maurosollar/STM32H562RGT6-InvPend/README.md

# Pêndulo invertido

Projeto experimental de um sistema de pêndulo invertido utilizando STM32H562RGT6, driver DM556 e motor de passo para estudo de controle PID e LQR. O objetivo é desenvolver uma plataforma open-source para estudos de sistemas instáveis.

## Estratégia de Controle

O projeto utiliza duas etapas principais de controle:

### Swing-Up

Responsável por elevar o pêndulo da posição inferior até próximo da vertical.

O algoritmo aplica acelerações controladas no carrinho para aumentar
gradualmente a energia do pêndulo até atingir a região de captura.

### Estabilização

Após atingir a região próxima da vertical de captura, o sistema troca automaticamente
para o controlador de estabilização.

Controladores previstos:

- PID
- LQR

A transição entre Swing-Up e estabilização ocorre automaticamente
baseada no ângulo do pêndulo.

## Documentação

- [Lista de materiais](./boom.txt)
- [Diagrama da placa STM32](./Docs/WeAct-STM32H5_64PIN-CoreBoard_V11%20SchDoc.pdf)

## Fotos

### STM32 / Driver  / Encoder de 2500 pulsos por revolução / Motor de passo

<p float="left">
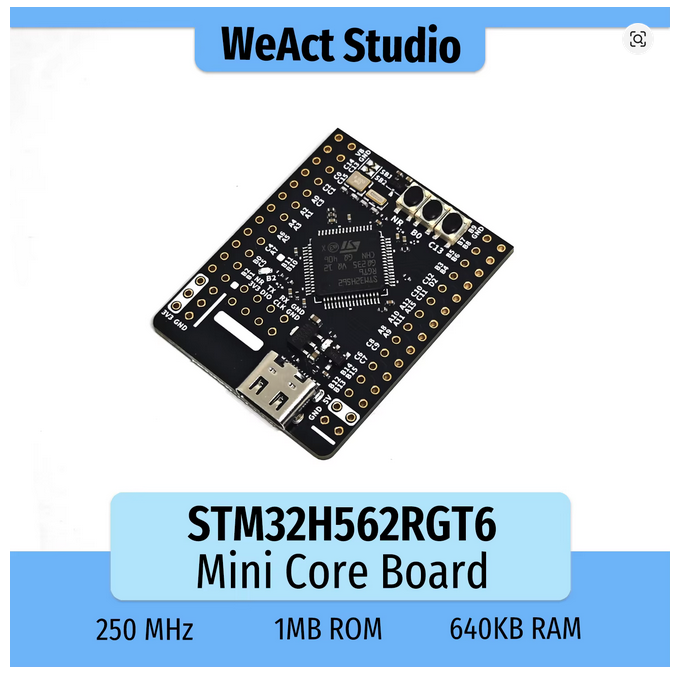
[picture p1: Docs/STM32H562RGT6.png]
    
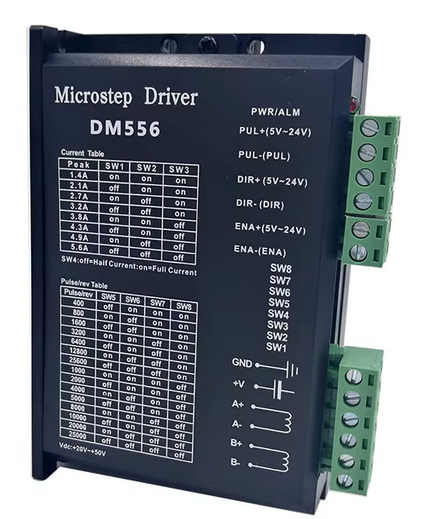
[picture p2: Docs/DM556.png]
    
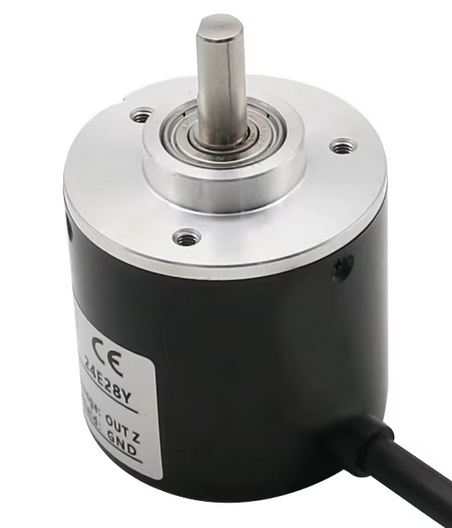
[picture p3: Docs/Encoder_Incremental.png]
    
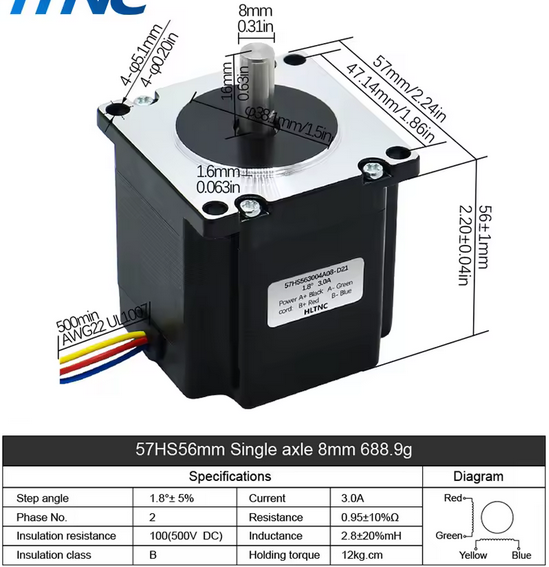
[picture p4: Docs/Nema23_Step_Motor.png]
        
</p>

### Início da separação dos materiais

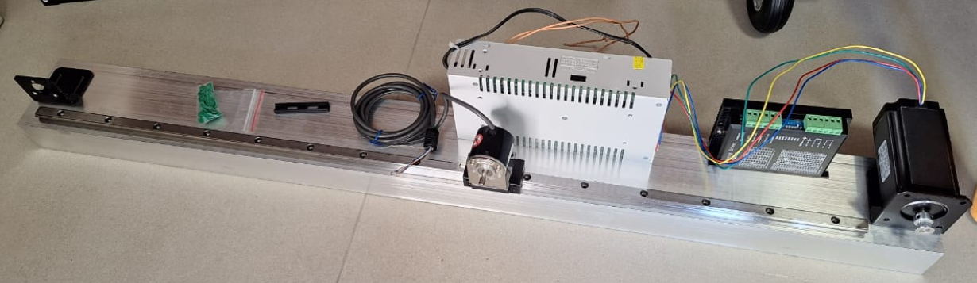
[picture p5: Docs/montagem01.png]


### Montagem final

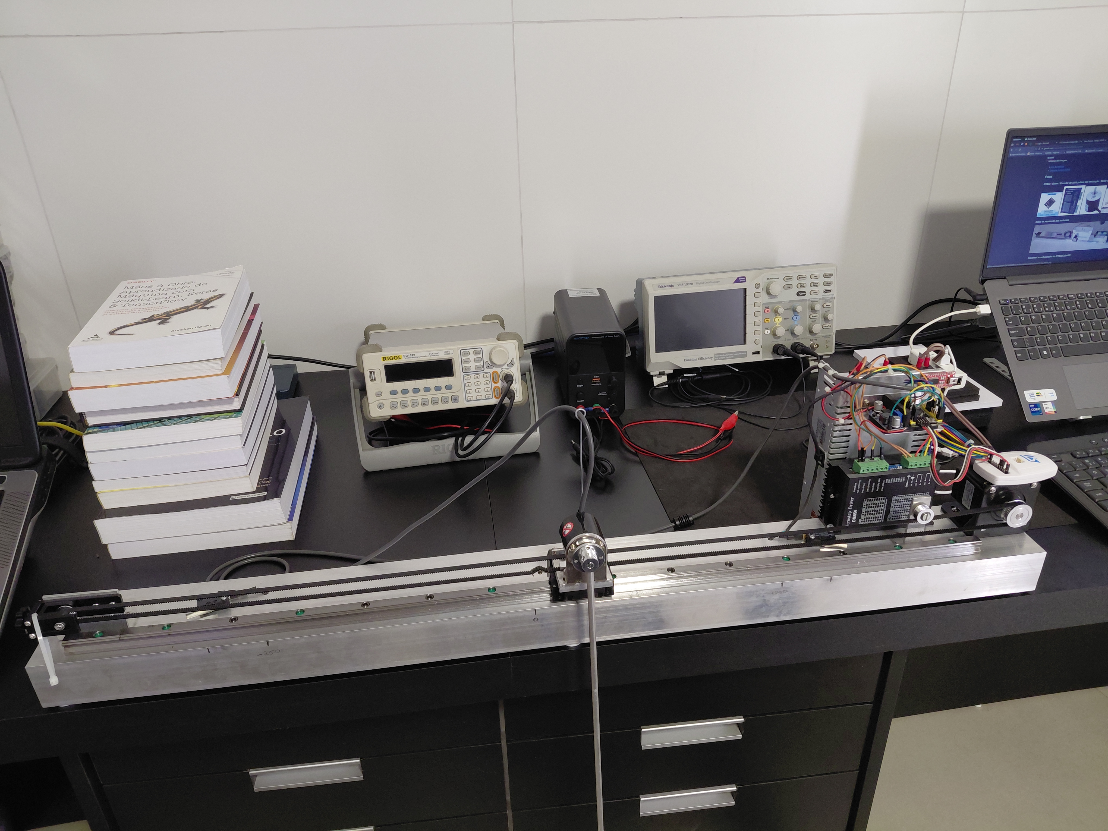
[picture p6: Docs/montagem_final.jpg]


### Iniciando a configuração do STM32CubeMX

```
STMCubeMX Version 6.17.0
Start My project from MCU
  Access to mcu selector
  
  For better performance it is recommended to enable the instruction cache (ICACHE)
  and the MPU to access OTP & RO areas.
  Do you want to apply now such default configuration? (YES)
  
  Do you want to create a new project:
  (*) Without TrustZone activated?
  
  Aba Project Manager
    Project Name: STM32H562RGT6-InvPend
    Toolchain / IDE: STMCubeIDE
  
  Linker Settings
    Minimum Heap Size 0x200
    Minimum Stack Size 0x400
    
  Aba Pinout & Configuration
    System Core
      RCC
        HSE: Crystal/Ceramic Resonator
        LSE: Crystal/Ceramic Resonator

    Trace and Debug
      DEBUG Mode and Copnfiguration
        Debug: Serial Wire        
        
  Aba Clock Configuration
    Input frequency LSE: 32.768KHz
    Input frequency HSE: 8MHz
    HCLK(MHz): 250
    Importante observar se o clock da USB esta a 48MHz, já que vamos utilizar
    a USB como Virtual Port Communications. Já Certo que estamos utilizando
    HSE e LSE ativado para utilizar Cristal externo.

=== Parte do encoder ===

Pinout & Configuration / Timers
  TIM2
    Combined Channels: Encoder Mode
      Configuration / User Constants
        Add
        Constant Name: ENCODER_RESOLUTION
        Constant Value: 9999 (10000 - 1 contagens por volta)
      Configuration / Parameter Settings    
        Counter Settings
          Counter Period (AutoReloadRegister 32bits): ENCODER_RESOLUTION
          Internal Clock Division(CKD): No Division
          auto-reload preload: Enable
        Encoder
          Encoder Mode: Encoder Mode TI1 and TI2
          __ Parameters for Channel 1 ___
          Polarity: Falling Edge
          Input filter: 10
          __ Parameters for Channel 2 ___
          Polarity: Falling Edge
          Input filter: 10   
      Configuration / NVIC Settings
        TIM2 global interrupt ( )  Obs.: Interupção de over ou underflow, não ativado.
      Configuration / GPIO Settings
        Fazer para PA0 e PA1
        GPIO pull-up/Pull-down: Pull-up

=== Configurar GPIO's de saída para PUL-, DIR- e ENA- ===
Pinout & Configuration
  Obs.: PUL- = PA2 associado com TIM5_CH3 PWM Generation
  PA9 e PA10 como GPIO_Output
  PA9 com label: DIR
  PA10 com label: ENA
  GPIO mode: Output Open Drain (Configurado como coletor aberto pelo fato do PUL+, DIR+ e ENA+
                                esta conectado no 5VDC)
  PA4 com label: Encoder_Rev como GPIO_Input Pull-up (Não utilizado)
  PA6 com label: Chave_Esq como GPIO_Input Pull-up
  PA7 com label: Chave_Dir como GPIO_Input Pull-up
  PB13 com label: Time_Int como GPIO_Output (Utilizado para debug de tempo de interrupção)
  PC11 com label: Time_Exec como GPIO_Output (Utilizado para debug de tempo de execuçao de código)

=== Configuração da UART ===
Pinout & Configuration
  Connectivity
    UART4
    UART4 Mode and Configuration
      Mode
        Mode: Asynchronous
      Configuration
        Parameters
          Baud Rate: 460800
          Word Length: 8 Bits
          Parity: None
          Stop Bits: 1
        NVIC Settings
          UART4 global interrupt [*]
        DMA Settings
          Clique em "Go to GPDMA1"

Logo clicando em "Go to GPDMA1" redireciona para o System Core
System Core
   GPDMA1
     Channel 0 -2 Words Internal FIFO : Standarda Request mode
       Request Configuration
         Request UART4_TX
       Channel configuration
         Direction Memory to Peripheral
       Source Data Setting
         Source Address increment After Transfer: Enabled
         Data Width: Byte
       Destination Data Setting
         Destination Address increment After Transfer: Disable
         Data Width: Byte
Obs.: Foram ativados PC10=UART4_TX e PA11=UART4_RX

=== Configurando Timer para interrupção por software de 1 ms ===
Pinout & Configuration
  Timers
    TIM3
      Mode
        Clock Source: Internal Clock (Na árvore de clock APB1 Timer clock = 250MHz)
      Configuration
        Parameters Settings
          Prescaler (PSC - 16 bits value): 250-1 (Então o timer incrementa a cada 1 MHZ)
          Counter Period: 1000-1 ( 1us * 1000 = 1ms)
        NVIC Settings
          TIM3 global interrupt (*)
          
=== Configurando Timer 4 para rotina de atraso em us === 
Pinout & Configuration
  Timers
    TIM4
      Mode
        Clock Source: Internal Clock (Na árvore de clock APB1 Timer clock = 250MHz)
      Configuration
        Parameters Settings
          Prescaler (PSC - 16 bits value): 250-1 (Então o timer incrementa a cada 1 MHZ)
          Somente isto, lembrando que o o registrador é de 16 bits, então só conseguimos +-65ms de atraso

=== Configurando PWM variável para controle de pulsos do driver do motor de passo ===
Pinout & Configuration
  Timers
    TIM5
      Mode
        Clock Source: Internal Clock (Na árvore de clock APB1 Timer clock = 250MHz
        Channel1: PWM Generation CH1  (PA2 - TIM5_CH3 = PUL do driver motor de passo)
      Configuration
        Parameters Settings
          Counter Settings
            Prescaler (PSC - 16 bits value): 250-1 (Então o timer incrementa a cada 1 MHZ)
            Counter Period: 1000000-1 ( 1us * 1000000 = 1Hz) Alterado via software do pêndulo
            auto-reload preload: Enable ( o valor colocado no ARR via software prevalecerá na próxima contagem)
            Obs.: FreqPWM = clktim / (prescaler * ARR) no caso acima = 1KHz
                  Counter Period será alterado no software
                                 Freq = ARR e      CCR3(Counter Period) sempre a metade.    
                  Assim temos:   1Hz  = 1000000
                                 2Hz  = 500000
                                 1KHz = 1000
                                 2KHz = 500 Motor estável
                               2.5KHz = 400 Motor já não aceita alterações bruscas de velocidade
                                 5KHz = 200 
                                 
          PWM Generation Channel
            Pulse (16 bit value): 500 (Será laterado no software, sempre a metado do Counter Period)
                                      Para que o duty cycle do PWD seja 50%
            Fast Mode: Enable
        GPIO Settings
          GPIO mode: Alternate Function Open Drain
          Maximum output speed: High
 
=== Configurando Timer para contagem de pulsos gerados pelo PWM, possibilitando ter posicionamento do carro ===
Pinout & Configuration
  Timers
    TIM1
      Mode
        Clock Source: ETR2   (Ativa External Trigger 2, associando a GPIO PA12 = TIM1_ETR)
      Configuration
        Parameters Settings
          Prescaler (PSC - 16 bits value): 0
          Counter Period: 65535

No STM32CubeIDE:     
Ativar float format para para formatação com sprintf:
check your MCU Settings from "Project Properties > C/C++ Build >
Settings > Tool Settings", or add manually "-u _printf_float" in linker flag          

```

### Conexão do encoder rotativo OMCH 2500PR, Optoelectronic, E6B2-CWZ6C

```

  Conexão do Encoder ------  STM32 -------
- Shiel F.G - GND ---------  GND
- Brown ----- Vdc 5 a 24V -  5V
- Blue ------ OV ----------  GND
- Black ----- Out A phase -  PA0
- White ----- Out B phase -  PA1
- Orange ---- Out Z phase -  Não conectado

Obs.: Out Z phase -> Gera 1 pulso por revolução. (Não utilizei)
      Se o canal A muda antes do B -> gira em um sentido.
      Se o B muda antes do A -> gira no outro.
      Output circuit configuration: NPN Open-collector output
      Maximum response frequency: 100KHz

```

### Configuração do driver do motor de passo DM556 para o Motor de passo 57HS56-3004A08-D21

O driver tem um bloco de chaves com 8 dip switch, para descrição de cada um, veja imagem do driver acima. 
Adicionei esta tabela abaixo em função da figura não ter RMS, mas pode ser calculada assim (Peak = RMS * 1.4)
A corrente que vem estipulada no motor é RMS, no caso 3A, selecionei 2.7A RMS, um pouco abaixo da corrente do motor.

```

+-------------+
| Peak | RMS  |
+------+------+
| 2.1A | 1.5A |
+------+------+
| 2.7A | 1.9A |
+------+------+
| 3.2A | 2.3A |
+------+------+
| 3.8A | 2.7A |
+------+------+
| 4.3A | 3.1A |
+------+------+
| 4.9A | 3.5A |
+------+------+
| 5.6A | 4.0A |
+-------------+

Ficou assim:
SW1 = on  -\
SW2 = on   +--> Corrente RMS 2.7A
SW3 = off -/

SW4 = off = Half Current (Quando motor tiver parado, é energizado com meia corrente,
            salvo se ENA estiver desativado, neste caso o motor roda livre)

SW5 = off -\
SW6 = off   \ 1600 pulsos por revolução
SW7 = on    /
SW8 = on  -/

Ligações GPIOs do STM32 ao Driver. Obs.:(PUL+, DIR+ e ENA+ ligado ao 5VDC)
PA7  = PUL-
PA9  = DIR-
PA10 = ENA- 

```   

Polia GT2 tem 2mm por dente, então como utilizo de 40 dentes, a cada volta tem um deslocamento de 80mm
Motor que utilizo são 200 passos/volta
1 passo -> 80/200 = 0,4mm, mas como o driver esta configurado 1600 pulsos/volta, então 0,05mm/pulso

Peso da haste do pêndulo = 44.2g
Flange do pêndulo  = 9.1g
