maurosollar/STM32H562RGT6-InvPend/Docs/Guia_Linear_Desenho.webp

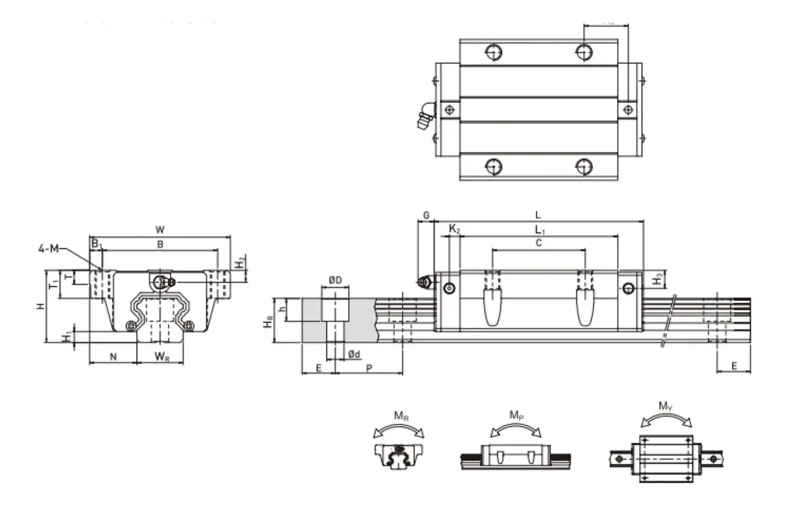
Docs/Guia_Linear_Desenho.webp
