maurosollar/STM32H562RGT6-InvPend/Docs/Guia_Linear_Medidas.webp

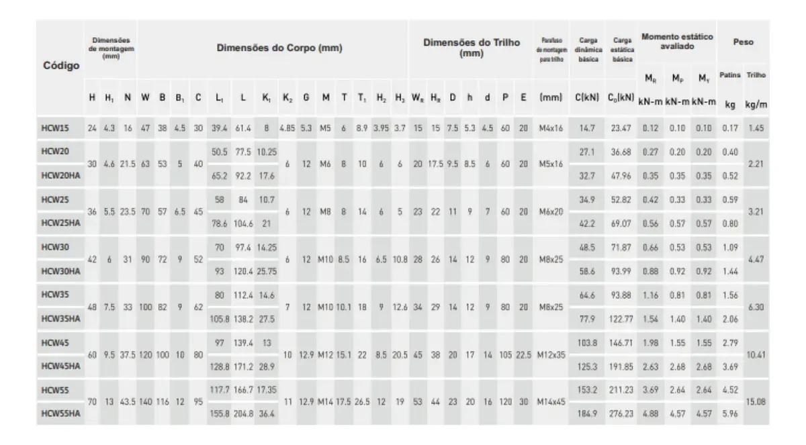
Docs/Guia_Linear_Medidas.webp
