maurosollar/STM32H562RGT6-InvPend/Docs/Motor_Passo_Nema23.png

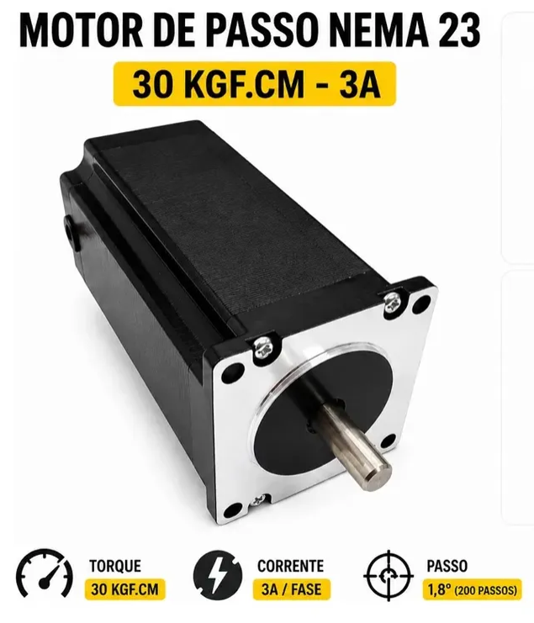
Docs/Motor_Passo_Nema23.png
