maurosollar/STM32H562RGT6-InvPend/Docs/suporte_nema23.png

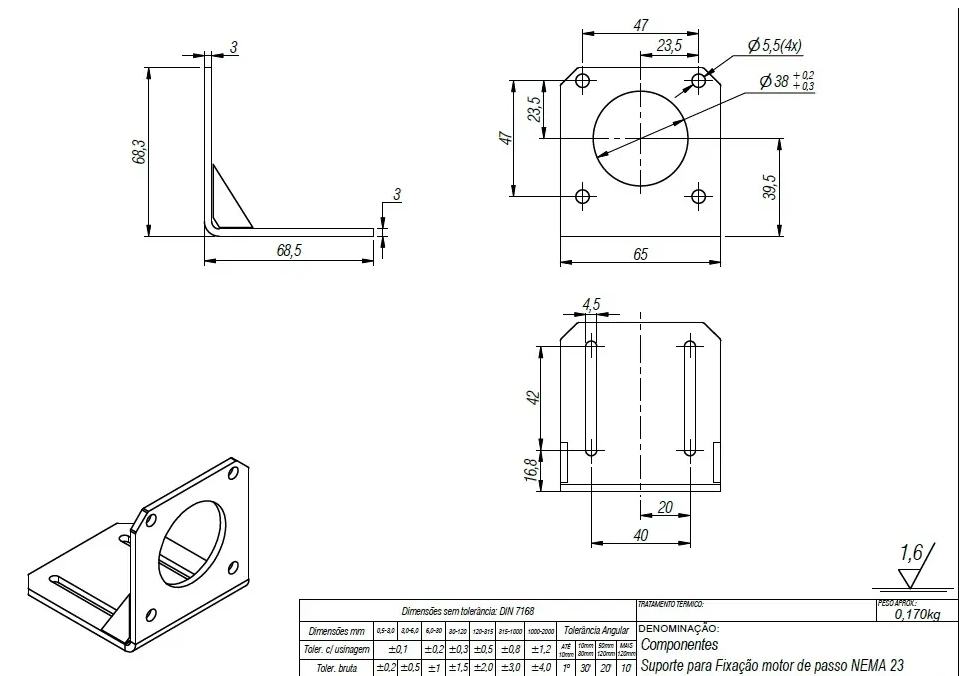
Docs/suporte_nema23.png
