maurosollar/STM32H562RGT6-InvPend/Docs/Dimension_Step_Motor.png

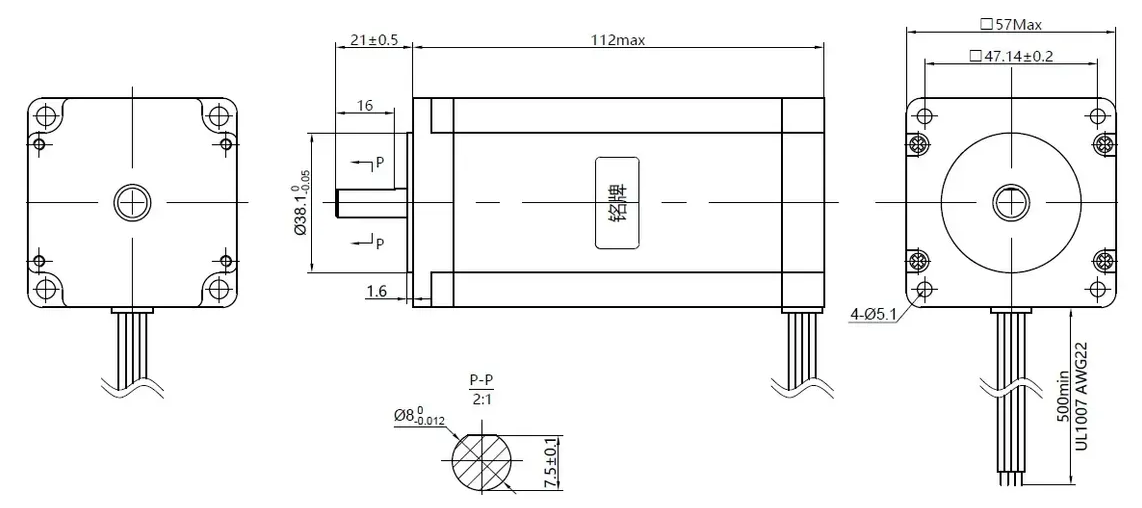
Docs/Dimension_Step_Motor.png
