maurosollar/STM32H562RGT6-InvPend/Docs/Test_condition_step_motor.png

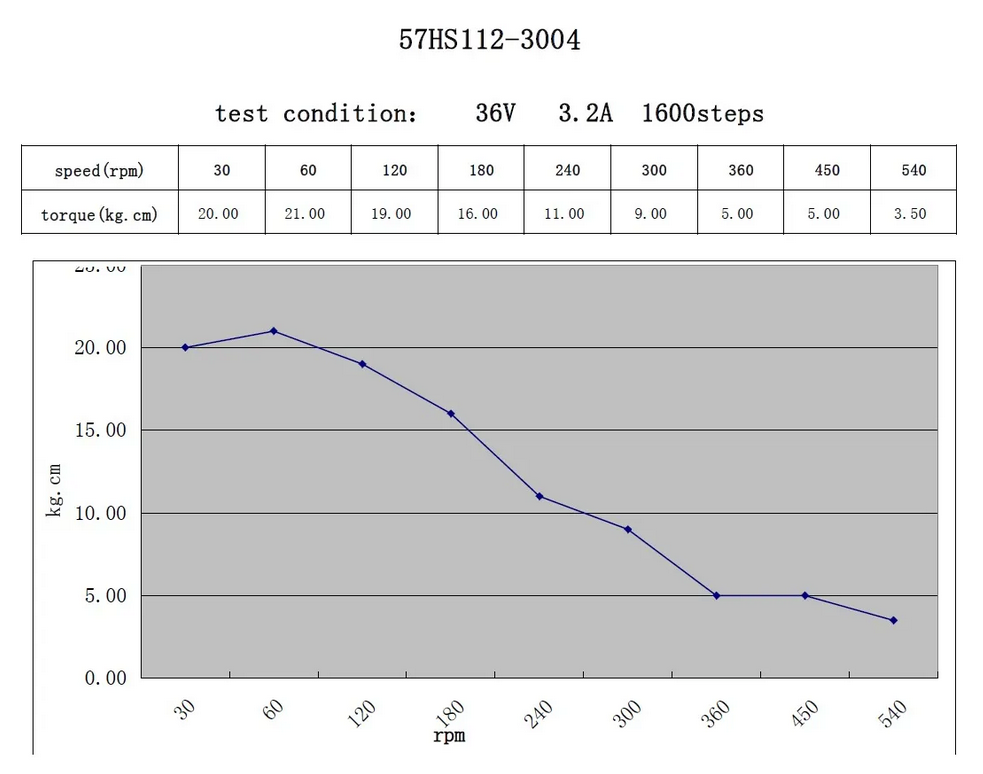
Docs/Test_condition_step_motor.png
