maurosollar/STM32H562RGT6-InvPend/Core/Src/main.c

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
/* Includes ------------------------------------------------------------------*/
#include "main.h"

/* USER CODE BEGIN Includes */
#include "stdio.h"
#include "string.h"
#include "penduloinvertido.h"

/* USER CODE END Includes */


TIM_HandleTypeDef htim1;
TIM_HandleTypeDef htim2;
TIM_HandleTypeDef htim3;
TIM_HandleTypeDef htim4;
TIM_HandleTypeDef htim5;

UART_HandleTypeDef huart4;
DMA_HandleTypeDef handle_GPDMA1_Channel0;

/* USER CODE BEGIN PV */
int32_t   tempo;            // Variável para testes de tempo
uint32_t  last_rx_time = 0; // Controle de tempo para expirar dado recebido pela UART
uint8_t   rx_buffer[3];     // Buffer do RX da UART
char      tx_buffer[35];    // Buffer do TX da UART
int32_t   excede_envio;     // Variável é incrementada caso tenha dados de simulação para enviar
                            // via serial antes de terminar o anterior (Serial 460800bps)
                            // significa que não esta dando tempo de enviar novos dados
                            // antes de acabar de enviar os dados anteriores.
                            // Obs.: Utilizada somente para análise e debug

volatile uint8_t uart_tx_busy = 0, flag_controle = 0;

Pendulo_t pendulo;

/* USER CODE END PV */

void SystemClock_Config(void);
static void MPU_Config(void);
static void MX_GPIO_Init(void);
static void MX_GPDMA1_Init(void);
static void MX_ICACHE_Init(void);
static void MX_UART4_Init(void);
static void MX_TIM2_Init(void);
static void MX_TIM3_Init(void);
static void MX_TIM5_Init(void);
static void MX_TIM4_Init(void);
static void MX_TIM1_Init(void);
/* USER CODE BEGIN 0 */

/**
 * @brief Rotina de atraso em ms, lembrar como o Timer 4 é de 16 bits, o atraso máximo é 65milisegundos
 */
void atraso_us(uint32_t us)
{
    __HAL_TIM_SET_COUNTER(&htim4,0); // Zera contador
    while(__HAL_TIM_GET_COUNTER(&htim4) < us);
 }

/**
 * @brief Ajusta PID com dados recebido do simulador no PC, normlamente de 0 a 100
 *		  Com isto temos os coeficientes Kp de 0 a 100, Ki e Kd de 0 a 0.1
 */
void HAL_UART_RxCpltCallback(UART_HandleTypeDef *huart)
{
	if (huart->Instance == UART4)
	{
		last_rx_time = HAL_GetTick();

        Pendulo_SetaPID(&pendulo, (float) rx_buffer[0],
        		                  (float) rx_buffer[1] / 1000,
						          (float) rx_buffer[2] / 1000);
	}
}

/**
 * @brief Descarta dados do buffer caso a UART não seja preenchida em 1 segundo
 */
void Expira_RX_Buffer_Simulador()

{
	if ((HAL_GetTick() - last_rx_time) > 1000 && rx_buffer[0] > 0)
	{
		memset(rx_buffer, 0, sizeof(rx_buffer));
		HAL_UART_AbortReceive_IT(&huart4);
		HAL_UART_Receive_IT(&huart4, rx_buffer, 3);
	}
}

/**
 * @brief Seta variável uart_tx_busy = 0 sinalizando que acabou a transmissão UART
 */
void HAL_UART_TxCpltCallback(UART_HandleTypeDef *huart)
{
	if (huart->Instance == UART4)
	{
		uart_tx_busy = 0;
	}
}

/**
 *  @brief Envia dados para o simulador no PC
 */
void Envia_simulador()
{
	if (uart_tx_busy == 0)
	{
		uart_tx_busy = 1;

		// Ângulo, Velocidade angular, posição do carro, velocidade do carro
		sprintf((char*)tx_buffer, "%.1f;%.1f;%d;%d\r\n",
				pendulo.angulo_pendulo,
				pendulo.velocidade_angular_pendulo,
				pendulo.posicao_carro,
				pendulo.velocidade_carro);
		HAL_UART_Transmit_DMA(&huart4, (uint8_t*)tx_buffer, strlen(tx_buffer));
	}
	else
	{
		excede_envio++;
	}
}

/**
 * @brief Esta função é chamada pelo timer 3 programado para cada 1 ms
 *        É o coração do controle do pêndulo invertido
 */
void HAL_TIM_PeriodElapsedCallback(TIM_HandleTypeDef *htim)
{
	if (htim == &htim3)
	{
	    flag_controle = 1;
	}
}


/* USER CODE END 0 */

/**
  * @brief  The application entry point.
  * @retval int
  */
int main(void)
{

  /* MCU Configuration--------------------------------------------------------*/

  /* MPU Configuration--------------------------------------------------------*/
  MPU_Config();

  /* Reset of all peripherals, Initializes the Flash interface and the Systick. */
  HAL_Init();

  /* Configure the system clock */
  SystemClock_Config();

  /* Initialize all configured peripherals */
  MX_GPIO_Init();
  MX_GPDMA1_Init();
  MX_ICACHE_Init();
  MX_UART4_Init();
  MX_TIM2_Init();
  MX_TIM3_Init();
  MX_TIM5_Init();
  MX_TIM4_Init();
  MX_TIM1_Init();
  /* USER CODE BEGIN 2 */
  HAL_TIM_Encoder_Start(&htim2, TIM_CHANNEL_ALL); // Inicia encoder
  HAL_UART_Receive_IT(&huart4, rx_buffer, 3); // Gera interrupção após UART preencher buffer com 3º bytes
  HAL_TIM_Base_Start(&htim4);

  // Inicializa GPIOs
  HAL_GPIO_WritePin(DIR_GPIO_Port, DIR_Pin, 1); // Motor 0 = Anti-horário, carro direita / 1 = Horário, carro esquerda
  HAL_GPIO_WritePin(ENA_GPIO_Port, ENA_Pin, 1); // Motor 1 = Habilitado / 0 = desabilitado
  HAL_GPIO_WritePin(Time_Int_GPIO_Port, Time_Int_Pin, 0); // Para análise com osciloscópio
  HAL_GPIO_WritePin(Time_Exec_GPIO_Port, Time_Exec_Pin, 0); // Para análise com osciloscópio
  HAL_TIM_Base_Start(&htim1); //Inicia contagem de pulsos PWM do motor de passo
  /* USER CODE END 2 */

  /* Infinite loop */
  /* USER CODE BEGIN WHILE */

  HAL_Delay(500); // Atraso para estabilização

  /**
 * @brief Inicializa Pêndulo passando as referências necessárias
 *
 * @param pendulo - Estrutura principal
 * @param htim5 - Timer PWM
 * @param TIM_CHANNEL_3 - Canal PWM
 * @param Chave_Dir_GPIO_Port - GPIO chave de fim de curso direita
 * @param Chave_Dir_Pin - Pino associado
 * @param Chave_Esq_GPIO_Port - GPIO chave de fim de curso esquerda
 * @param Chave_Esq_Pin - Pino associado
 * @param DIR_GPIO_Port - Direção do motor
 * @param DIR_Pin - Pino associado
 * @param htim1 - Contador de pulsos
 * @param htim2 - Encoder
 */
  Pendulo_Inicializa(&pendulo, &htim5, TIM_CHANNEL_3,
		             Chave_Dir_GPIO_Port, Chave_Dir_Pin,
					 Chave_Esq_GPIO_Port, Chave_Esq_Pin,
					 DIR_GPIO_Port, DIR_Pin,
					 &htim1, &htim2);

  HAL_TIM_Base_Start_IT(&htim3); // Inicia interrupção para o controle do pêndulo

  while (1)
  {
    /* USER CODE END WHILE */

    /* USER CODE BEGIN 3 */
	if (flag_controle == 1)
	{
        Pendulo_AtualizaPendulo(&pendulo);

	    Expira_RX_Buffer_Simulador();
	    Envia_simulador();

		flag_controle = 0;
	}
  }
  /* USER CODE END 3 */
}

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
 /* MPU Configuration */

void MPU_Config(void)
{
  MPU_Region_InitTypeDef MPU_InitStruct = {0};
  MPU_Attributes_InitTypeDef MPU_AttributesInit = {0};

  /* Disables the MPU */
  HAL_MPU_Disable();

  /** Initializes and configures the Region 0 and the memory to be protected
  */
  MPU_InitStruct.Enable = MPU_REGION_ENABLE;
  MPU_InitStruct.Number = MPU_REGION_NUMBER0;
  MPU_InitStruct.BaseAddress = 0x08FFF000;
  MPU_InitStruct.LimitAddress = 0x08FFFFFF;
  MPU_InitStruct.AttributesIndex = MPU_ATTRIBUTES_NUMBER0;
  MPU_InitStruct.AccessPermission = MPU_REGION_ALL_RO;
  MPU_InitStruct.DisableExec = MPU_INSTRUCTION_ACCESS_DISABLE;
  MPU_InitStruct.IsShareable = MPU_ACCESS_NOT_SHAREABLE;

  HAL_MPU_ConfigRegion(&MPU_InitStruct);

  /** Initializes and configures the Attribute 0 and the memory to be protected
  */
  MPU_AttributesInit.Number = MPU_ATTRIBUTES_NUMBER0;
  MPU_AttributesInit.Attributes = INNER_OUTER(MPU_NOT_CACHEABLE);

  HAL_MPU_ConfigMemoryAttributes(&MPU_AttributesInit);
  /* Enables the MPU */
  HAL_MPU_Enable(MPU_PRIVILEGED_DEFAULT);

}

/**
  * @brief  This function is executed in case of error occurrence.
  * @retval None
  */
void Error_Handler(void)
{
  /* USER CODE BEGIN Error_Handler_Debug */
  /* User can add his own implementation to report the HAL error return state */
  __disable_irq();
  while (1)
  {
  }
  /* USER CODE END Error_Handler_Debug */
}
#ifdef USE_FULL_ASSERT
/**
  * @brief  Reports the name of the source file and the source line number
  *         where the assert_param error has occurred.
  * @param  file: pointer to the source file name
  * @param  line: assert_param error line source number
  * @retval None
  */
void assert_failed(uint8_t *file, uint32_t line)
{
  /* USER CODE BEGIN 6 */
  /* User can add his own implementation to report the file name and line number,
     ex: printf("Wrong parameters value: file %s on line %d\r\n", file, line) */
  /* USER CODE END 6 */
}
#endif /* USE_FULL_ASSERT */
