maurosollar/STM32H562RGT6-InvPend/STM32H562RGT6-InvPend.ioc

Mcu.UserName=STM32H562RGTx
PA0.Signal=S_TIM2_CH1
PA1.Signal=S_TIM2_CH2
PA10.GPIO_Label=ENA
PA10.Signal=GPIO_Output
PA11.Signal=UART4_RX
PA12.Signal=S_TIM1_ETR
PA13(JTMS/SWDIO).Signal=DEBUG_JTMS-SWDIO
PA14(JTCK/SWCLK).Signal=DEBUG_JTCK-SWCLK
PA2.Signal=S_TIM5_CH3
PA4.GPIO_Label=Encoder_Rev
PA4.Signal=GPIO_Input
PA6.GPIO_Label=Chave_Esq
PA6.Signal=GPIO_Input
PA7.GPIO_Label=Chave_Dir
PA7.Signal=GPIO_Input
PA9.GPIO_Label=DIR
PA9.Signal=GPIO_Output
PB13.GPIO_Label=Time_Int
PB13.Signal=GPIO_Output
PC10.Signal=UART4_TX
PC11.GPIO_Label=Time_Exec
PC11.Signal=GPIO_Output
PC14-OSC32_IN(OSC32_IN).Signal=RCC_OSC32_IN
PC15-OSC32_OUT(OSC32_OUT).Signal=RCC_OSC32_OUT
PH0-OSC_IN(PH0).Signal=RCC_OSC_IN
PH1-OSC_OUT(PH1).Signal=RCC_OSC_OUT
