maurosollar/STM32H562RGT6-InvPend/Core/Inc/main.h

#define ENCODER_RESOLUTION 9999
#define Encoder_Rev_Pin GPIO_PIN_4
#define Encoder_Rev_GPIO_Port GPIOA
#define Chave_Esq_Pin GPIO_PIN_6
#define Chave_Esq_GPIO_Port GPIOA
#define Chave_Dir_Pin GPIO_PIN_7
#define Chave_Dir_GPIO_Port GPIOA
#define Time_Int_Pin GPIO_PIN_13
#define Time_Int_GPIO_Port GPIOB
#define DIR_Pin GPIO_PIN_9
#define DIR_GPIO_Port GPIOA
#define ENA_Pin GPIO_PIN_10
#define ENA_GPIO_Port GPIOA
#define Time_Exec_Pin GPIO_PIN_11
#define Time_Exec_GPIO_Port GPIOC
