maurosollar/STM32H562RGT6-InvPend/(commit log)

2026-05-23 Configuração do encoder
2026-05-24 Ajustes encoder
2026-05-25 Fix pin connection details in README.md
2026-05-25 Acionamento do motor de passo
2026-05-28 Ativação da UART
2026-05-28 Acertos UART
2026-05-29 Serial RX com interupção e TX com DMA
2026-05-29 Ativado interrupção por software 1ms e pinos de saída para debug
2026-05-31 Início da biblioteca + chaves de fim de curso
2026-05-31 Acertos encoder
2026-06-01 Acerto timer encoder
2026-06-04 Velocidade motor
2026-06-05 Rotina de atraso us
2026-06-06 Acerto velocidade e direção
2026-06-06 Alterado porta UART
2026-06-07 Ajustes PID
2026-06-07 Acerto envio de dados para o simulador
2026-06-08 Acertos PID
2026-06-09 Acertos PID + compensação da posição do carro
2026-06-14 Velocidade Angular
2026-06-15 Ajustes velocidade angular
